MarkNowell/mega485/mega485.kicad_pcb

## KiCad design mega485.kicad_pcb (2022-11-30)

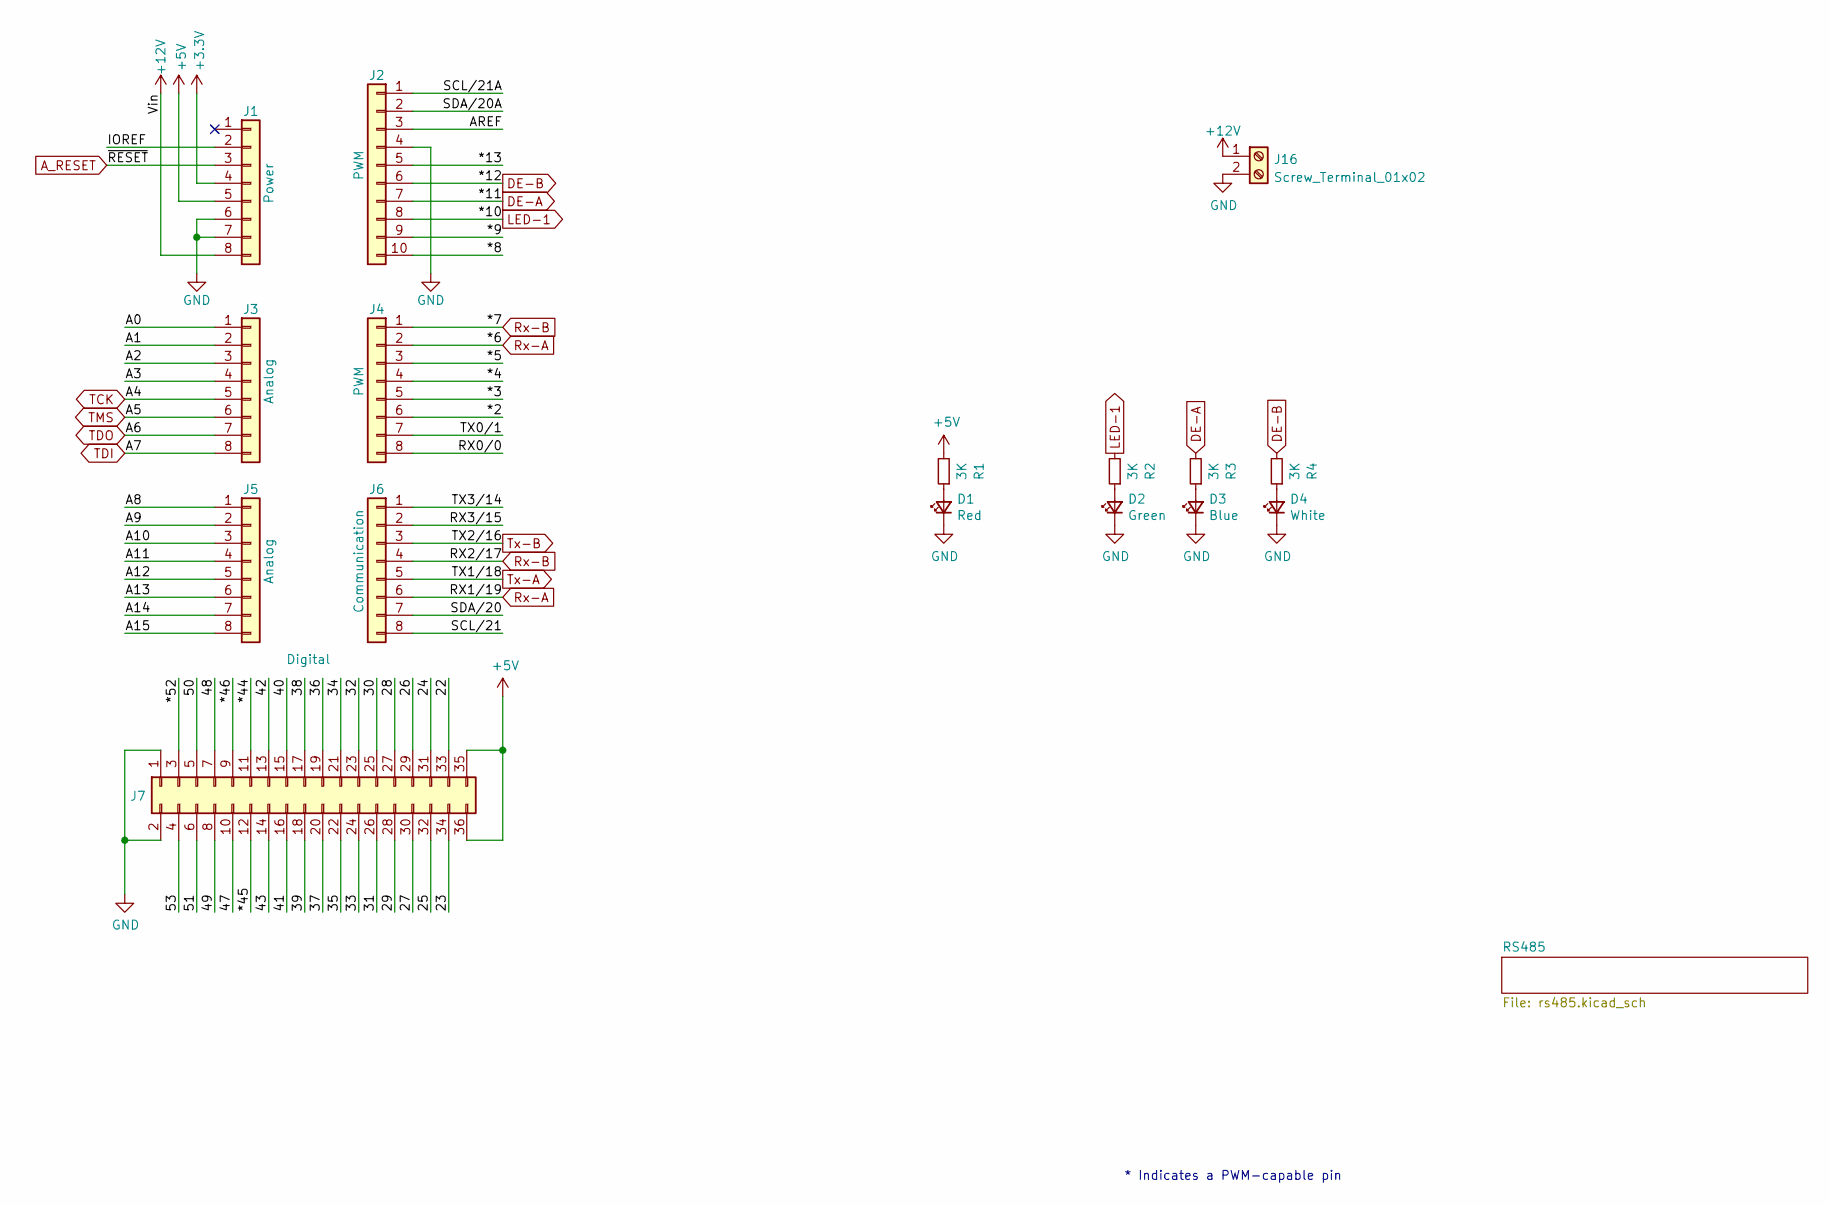
[picture p1: schematic mega485.kicad_sch]

Parts:
D1: Red; LED_0805_2012Metric; JLC C84256
D2: Green; LED_0805_2012Metric; JLC C2297
D3: Blue; LED_0805_2012Metric; JLC C2293
D4: White; LED_0805_2012Metric; JLC C34499
J1: Power; PinSocket_1x08_P2.54mm_Vertical
J2: PWM; PinSocket_1x10_P2.54mm_Vertical
J3, J5: Analog; PinSocket_1x08_P2.54mm_Vertical
J4: PWM; PinSocket_1x08_P2.54mm_Vertical
J6: Communication; PinSocket_1x08_P2.54mm_Vertical
J7: Digital; PinSocket_2x18_P2.54mm_Vertical
J16: Screw_Terminal_01x02; TerminalBlock_bornier-2_P5.08mm
R1, R2, R3, R4: 3K; R_0805_2012Metric; JLC C26010

Connections:
+3V3: J1.4
+5V: J1.5, J7.35, J7.36, R1.2; also elsewhere on the board
+12V: J1.8, J16.1
/22: J7.33
/23: J7.34
/24: J7.31
/25: J7.32
/26: J7.29
/27: J7.30
/28: J7.27
/29: J7.28
/30: J7.25
/31: J7.26
/32: J7.23
/33: J7.24
/34: J7.21
/35: J7.22
/36: J7.19
/37: J7.20
/38: J7.17
/39: J7.18
/40: J7.15
/41: J7.16
/42: J7.13
/43: J7.14
/47: J7.10
/48: J7.7
/49: J7.8
/50: J7.5
/51: J7.6
/53: J7.4
/*2: J4.6
/*3: J4.5
/*4: J4.4
/*5: J4.3
/*8: J2.10
/*9: J2.9
/*13: J2.5
/*44: J7.11
/*45: J7.12
/*46: J7.9
/*52: J7.3
/A0: J3.1
/A1: J3.2
/A2: J3.3
/A3: J3.4
/A8: J5.1
/A9: J5.2
/A10: J5.3
/A11: J5.4
/A12: J5.5
/A13: J5.6
/A14: J5.7
/A15: J5.8
/AREF: J2.3
/IOREF: J1.2
/RX0/0: J4.8
/RX3/15: J6.2
/SCL/21: J6.8
/SCL/21A: J2.1
/SDA/20: J6.7
/SDA/20A: J2.2
/TX0/1: J4.7
/TX3/14: J6.1
A_RESET: J1.3
DE-A: J2.7, R3.2; also elsewhere on the board
DE-B: J2.6, R4.2; also elsewhere on the board
GND: D1.1 (K), D2.1 (K), D3.1 (K), D4.1 (K), J1.6, J1.7, J2.4, J7.1, J7.2, J16.2; also elsewhere on the board
LED-1: J2.8, R2.2
unnamed: D1.2 (A), R1.1
unnamed: D2.2 (A), R2.1
unnamed: D3.2 (A), R3.1
unnamed: D4.2 (A), R4.1
Rx-A: J4.2, J6.6; also elsewhere on the board
Rx-B: J4.1, J6.4; also elsewhere on the board
TCK: J3.5
TDI: J3.8
TDO: J3.7
TMS: J3.6
Tx-A: J6.5; also elsewhere on the board
Tx-B: J6.3; also elsewhere on the board

Notes on the sheet:
* Indicates a PWM-capable pin

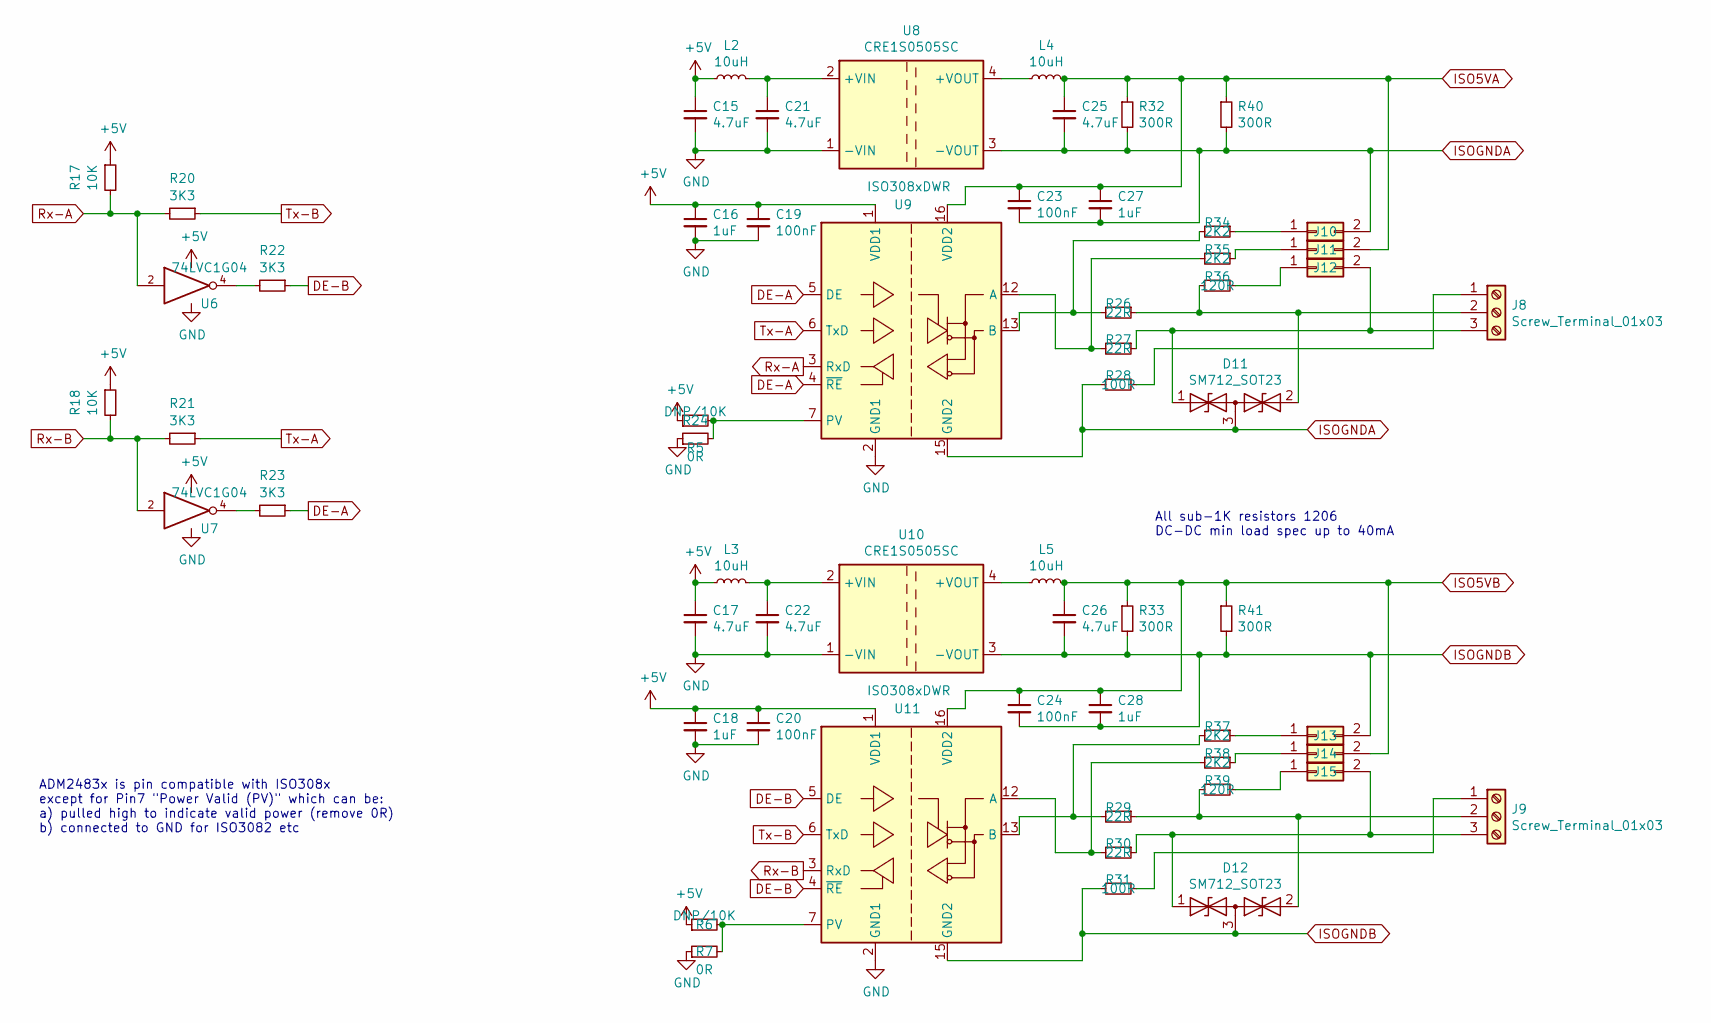
[picture p2: schematic rs485.kicad_sch]

Parts:
C15, C17, C21, C22, C25, C26: 4.7uF; C_1206_3216Metric; JLC C29823
C16, C18, C27, C28: 1uF; C_0603_1608Metric; JLC C15849
C19, C20, C23, C24: 100nF; C_0603_1608Metric; JLC C14663
D11, D12: SM712_SOT23; SOT-23; JLC C32677
J8, J9: Screw_Terminal_01x03; TerminalBlock_bornier-3_P5.08mm
J10, J11, J12, J13, J14, J15: Conn_02x01; PinHeader_1x02_P2.54mm_Vertical
L2, L3, L4, L5: 10uH; L_0805_2012Metric; JLC C1046
R5, R7: 0R; R_0805_2012Metric; JLC C17477
R6, R24: DNP/10K; R_0805_2012Metric; JLC-Alt C17414
R17, R18: 10K; R_0805_2012Metric; JLC C17414
R20, R21, R22, R23: 3K3; R_0805_2012Metric; JLC C26010
R26, R27, R29, R30: 22R; R_1206_3216Metric; JLC C17958
R28, R31: 100R; R_1206_3216Metric; JLC C17901
R32, R33, R40, R41: 300R; R_1206_3216Metric; JLC C17887
R34, R35, R37, R38: 2K2; R_0805_2012Metric; JLC C17520
R36, R39: 120R; R_1206_3216Metric; JLC C17909
U6, U7: 74LVC1G04; SOT-23-5; JLC C12509
U8, U10: CRE1S0505SC; Converter_DCDC_muRata_CRE1xxxxxxSC_THT
U9, U11: ISO308xDWR; SOIC-16W_7.5x10.3mm_P1.27mm; JLC C21710

Connections:
+5V: C15.1, C16.1, C17.1, C18.1, C19.1, C20.1, L2.1, L3.1, R6.1, R17.1, R18.1, R24.1, U6.5 (VCC), U7.5 (VCC), U9.1 (VDD1), U11.1 (VDD1); also elsewhere on the board
DE-A: R23.1, U9.4 (~RE), U9.5 (DE); also elsewhere on the board
DE-B: R22.1, U11.4 (~RE), U11.5 (DE); also elsewhere on the board
GND: C15.2, C16.2, C17.2, C18.2, C19.2, C20.2, C21.2, C22.2, R5.1, R7.1, U6.3 (GND), U7.3 (GND), U8.1 (-VIN), U9.2 (GND1), U9.8 (GND1), U10.1 (-VIN), U11.2 (GND1), U11.8 (GND1); also elsewhere on the board
ISO5VA: C23.1, C25.1, C27.1, J11.2, L4.2, R32.1, R40.1, U9.16 (VDD2)
ISO5VB: C24.1, C26.1, C28.1, J14.2, L5.2, R33.1, R41.1, U11.16 (VDD2)
ISOGNDA: C23.2, C25.2, C27.2, D11.3 (common), J10.2, R28.2, R32.2, R40.2, U8.3 (-VOUT), U9.9 (GND2), U9.15 (GND2)
ISOGNDB: C24.2, C26.2, C28.2, D12.3 (common), J13.2, R31.2, R33.2, R41.2, U10.3 (-VOUT), U11.9 (GND2), U11.15 (GND2)
unnamed: C21.1, L2.2, U8.2 (+VIN)
unnamed: C22.1, L3.2, U10.2 (+VIN)
unnamed: D11.1 (A1), J8.3, J12.2, R27.1
unnamed: D11.2 (A2), J8.2, R26.1, R36.2
unnamed: D12.1 (A1), J9.3, J15.2, R30.1
unnamed: D12.2 (A2), J9.2, R29.1, R39.2
unnamed: J8.1, R28.1
unnamed: J9.1, R31.1
unnamed: J10.1, R34.1
unnamed: J11.1, R35.1
unnamed: J12.1, R36.1
unnamed: J13.1, R37.1
unnamed: J14.1, R38.1
unnamed: J15.1, R39.1
unnamed: L4.1, U8.4 (+VOUT)
unnamed: L5.1, U10.4 (+VOUT)
unnamed: R6.2, R7.2, U11.7 (PV)
unnamed: R22.2, U6.4
unnamed: R23.2, U7.4
unnamed: R5.2, R24.2, U9.7 (PV)
unnamed: R26.2, R34.2, U9.13 (B)
unnamed: R27.2, R35.2, U9.12 (A)
unnamed: R29.2, R37.2, U11.13 (B)
unnamed: R30.2, R38.2, U11.12 (A)
Rx-A: R17.2, R20.2, U6.2, U9.3 (RxD); also elsewhere on the board
Rx-B: R18.2, R21.2, U7.2, U11.3 (RxD); also elsewhere on the board
Tx-A: R21.1, U9.6 (TxD); also elsewhere on the board
Tx-B: R20.1, U11.6 (TxD); also elsewhere on the board

Notes on the sheet:
ADM2483x is pin compatible with ISO308x except for Pin7 "Power Valid (PV)" which can be: a) pulled high to indicate valid power (remove 0R) b) connected to GND for ISO3082 etc
All sub-1K resistors 1206 DC-DC min load spec up to 40mA

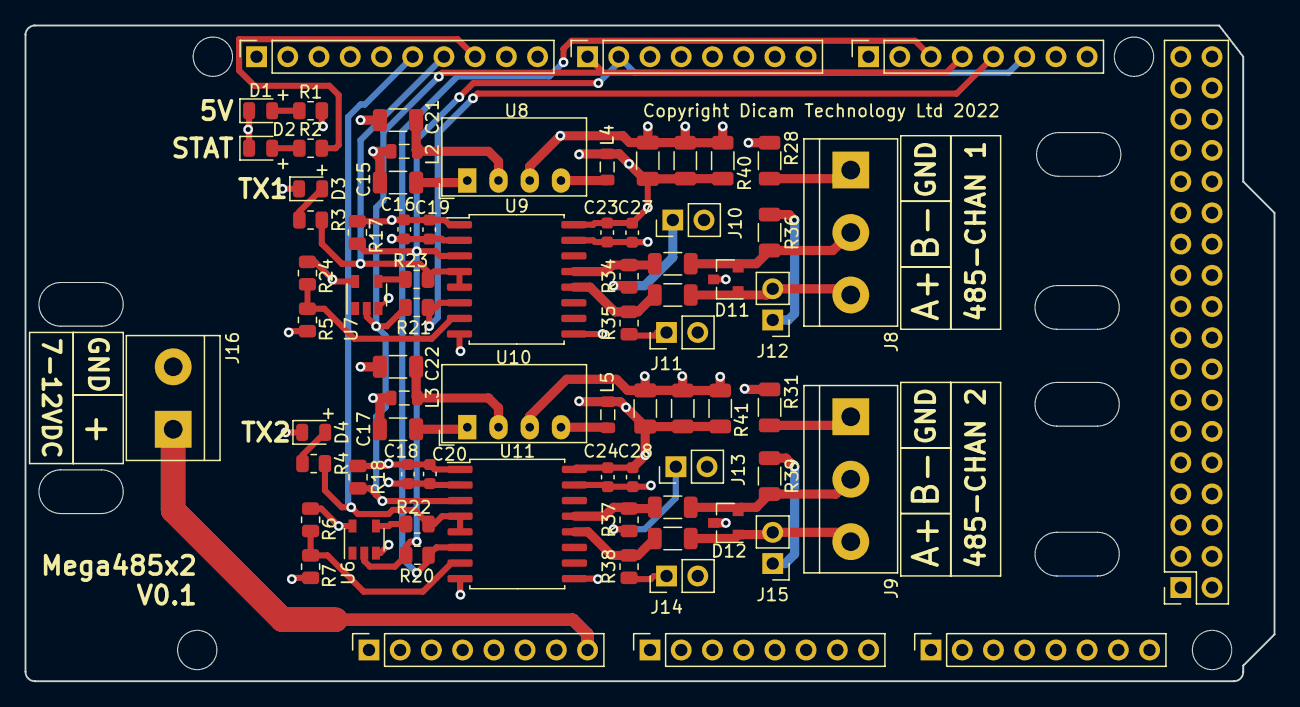
[picture p3: board mega485.kicad_pcb from above]

Board: 4 copper layers, 101.6 x 53.3 mm, 80 parts (0 on the bottom side), 42 nets.

Other parts of the board:
MH1, MH2, MH5, MH6: MountingHole_3.2mm
