MarkNowell/mega485/(commit log)

2022-11-29 Mega485 initial commit - design as per Nov22 JLC order with via errors on the 485 Chan1 block
    [BOM-mega485.csv, Mega485Pins.ods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]
2022-11-30 Fix incorrect connection between ISO5VA and ISOGNDA (fix associated planes in pcb)
    [mega485.kicad_pcb, rs485.kicad_sch]
