MarkNowell/mega485/(notices)

Notices in the files:
mega485.kicad_pcb:
Copyright Dicam Technology Ltd 2022
